quentinorh/biodata-pico/pics/001.jpg

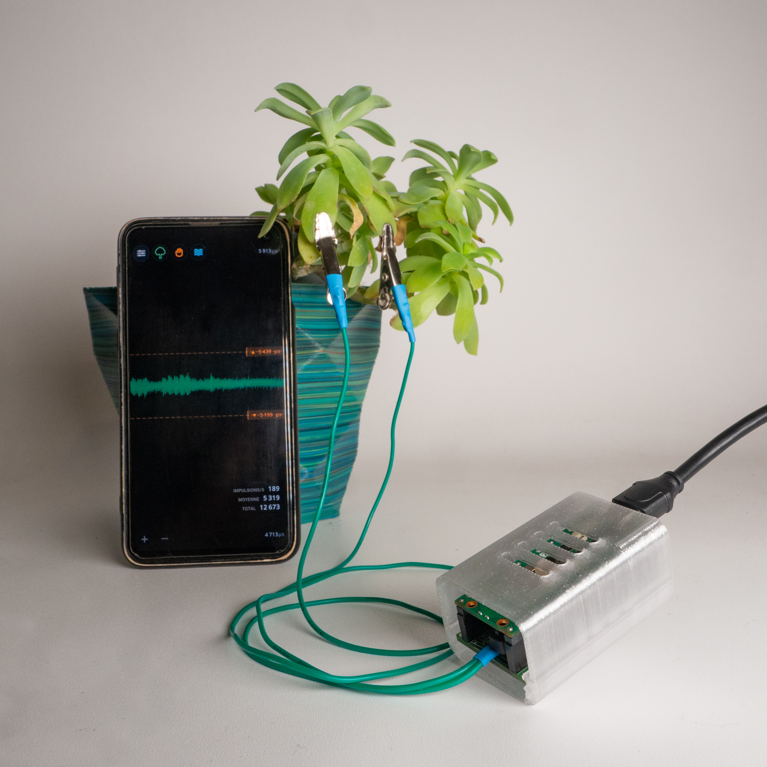
pics/001.jpg
