quentinorh/biodata-pico/pics/002.jpg

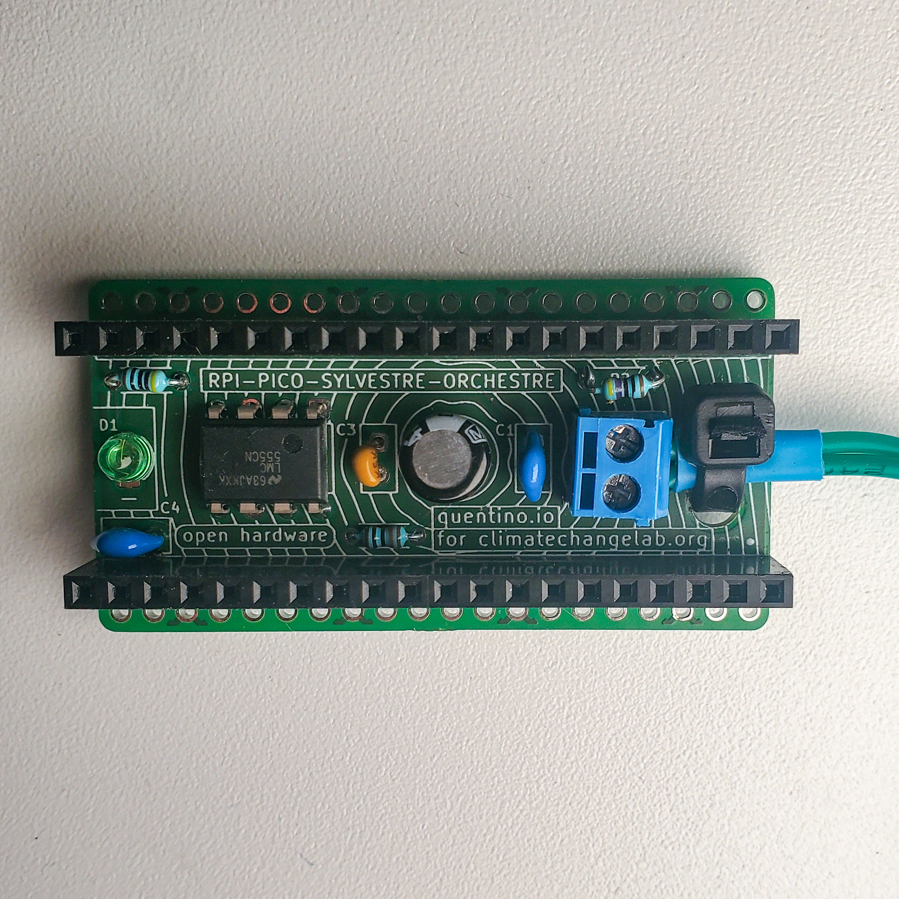
pics/002.jpg
