quentinorh/biodata-pico/pics/003.jpg

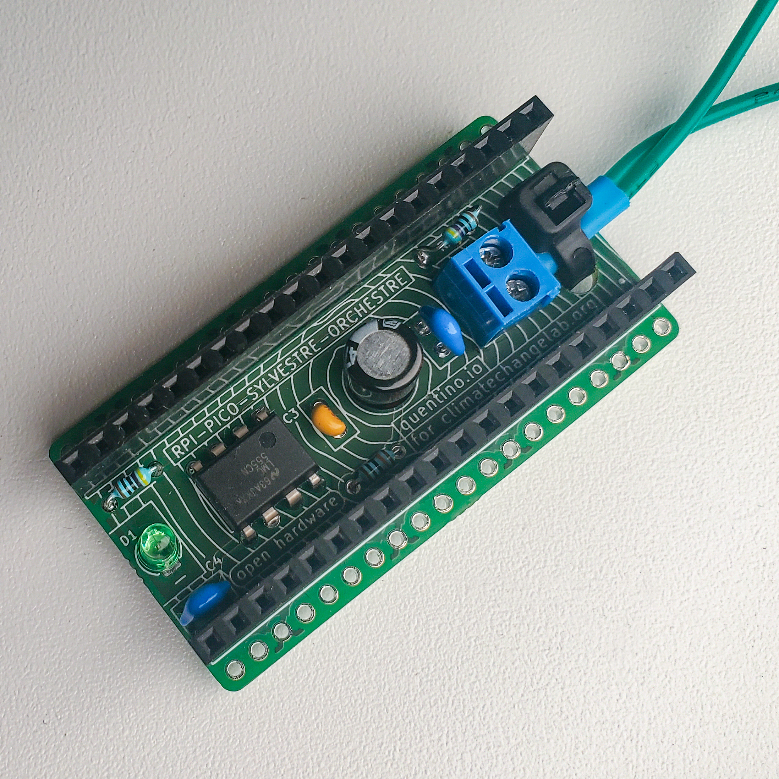
pics/003.jpg
