quentinorh/biodata-pico/pics/004.jpg

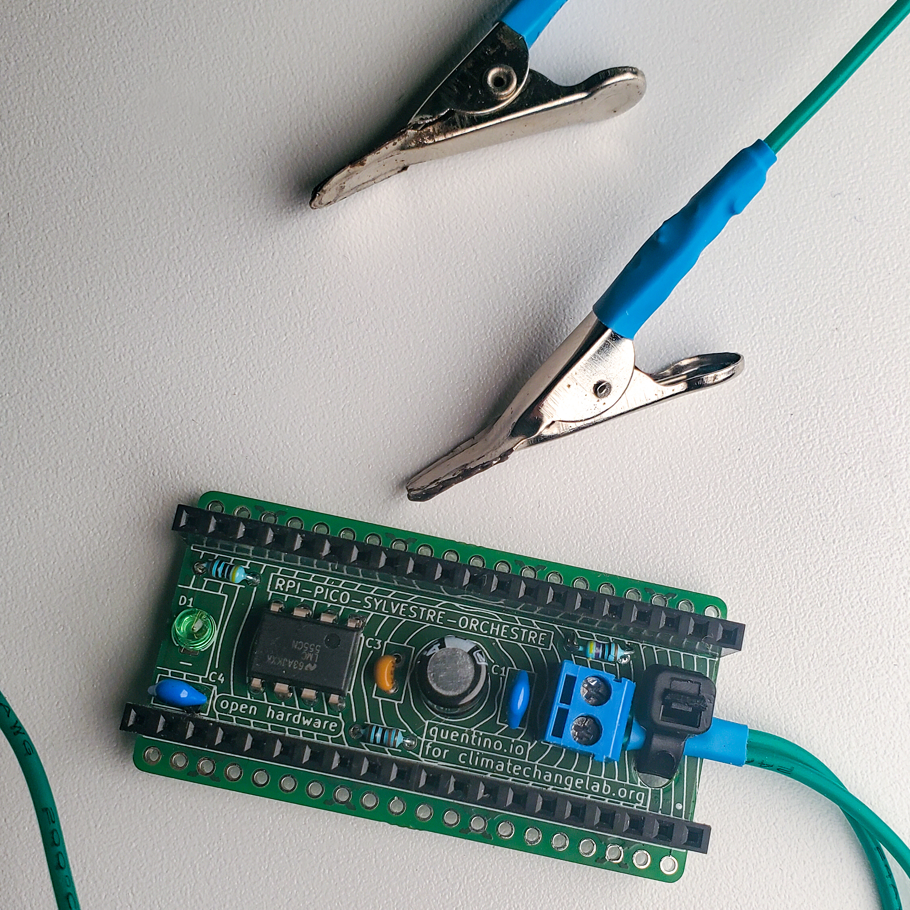
pics/004.jpg
