quentinorh/biodata-pico/pics/005.jpg

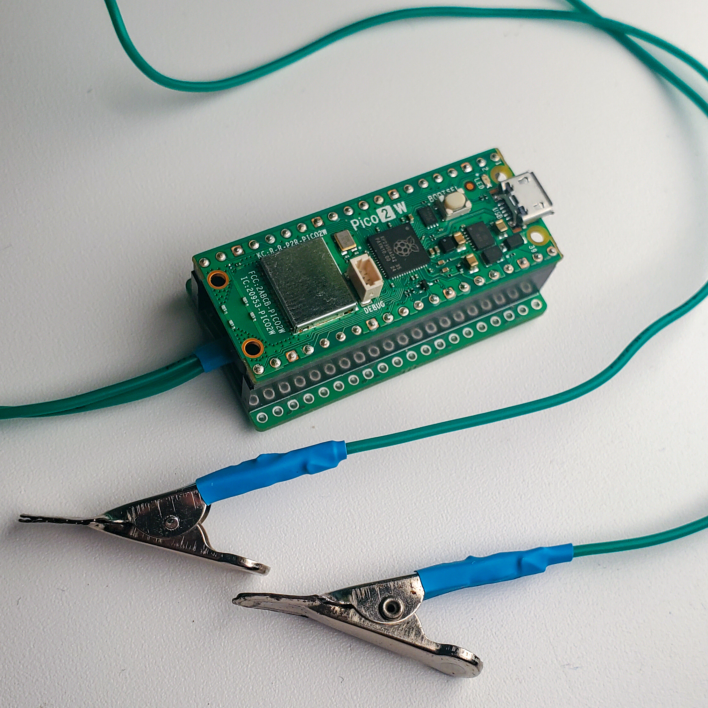
pics/005.jpg
