quentinorh/biodata-pico/pics/006.jpg

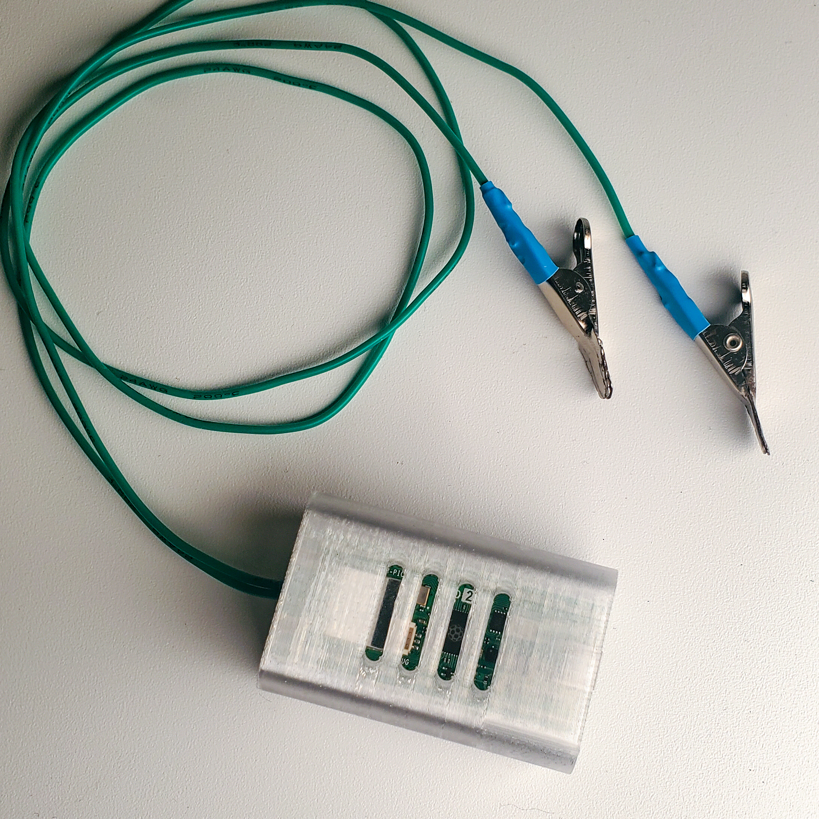
pics/006.jpg
