quentinorh/biodata-pico/pics/007.jpg

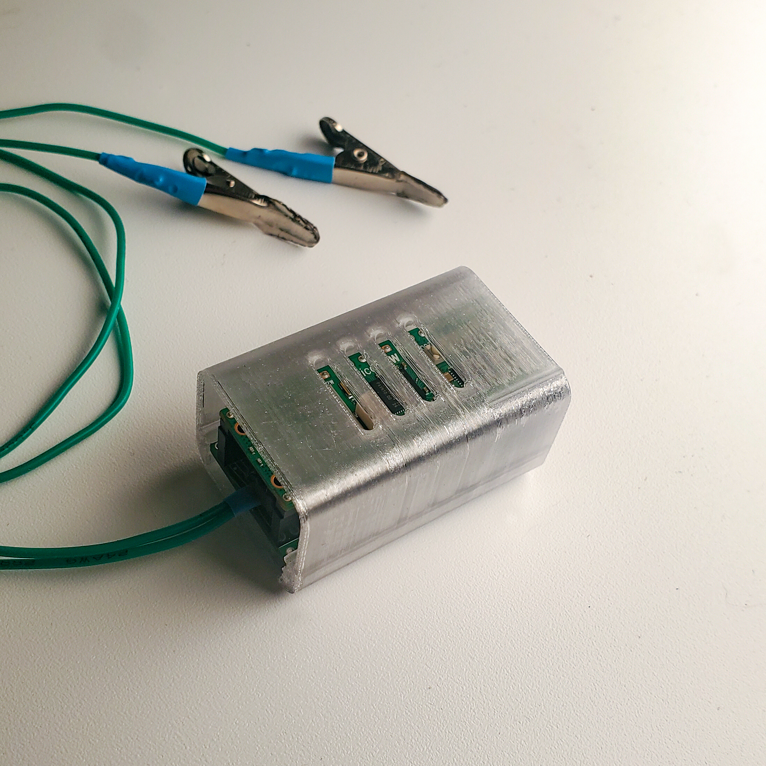
pics/007.jpg
