quentinorh/biodata-pico/touchdesigner/previews/04-fort.png

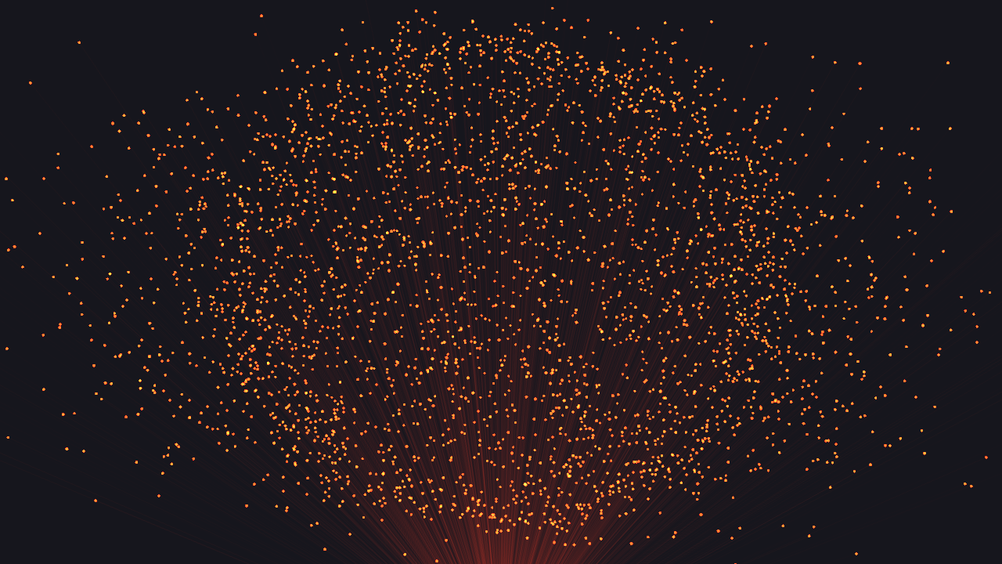
touchdesigner/previews/04-fort.png
