quentinorh/biodata-pico/touchdesigner/previews/05-tetraedre.png

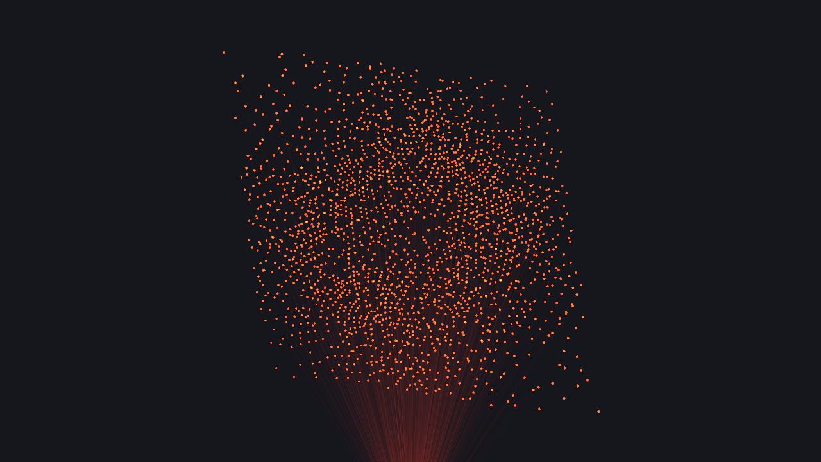
touchdesigner/previews/05-tetraedre.png
