quentinorh/biodata-pico/touchdesigner/previews/06-cube.png

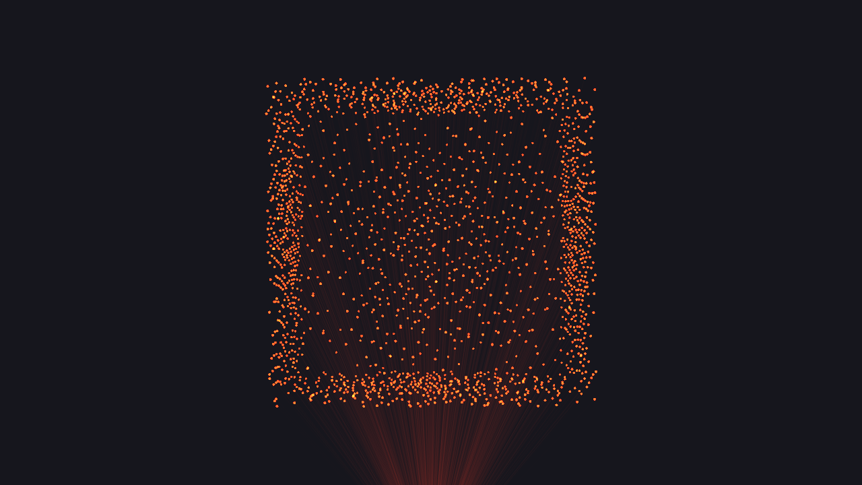
touchdesigner/previews/06-cube.png
