quentinorh/biodata-pico/touchdesigner/previews/07-octaedre.png

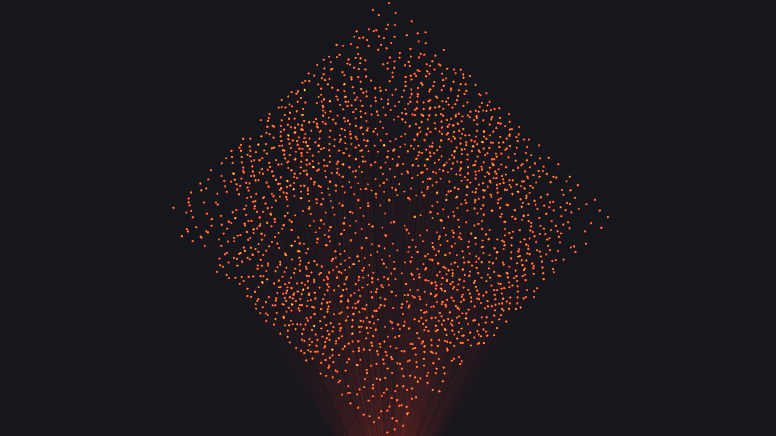
touchdesigner/previews/07-octaedre.png
