quentinorh/biodata-pico/touchdesigner/previews/08-dodecaedre.png

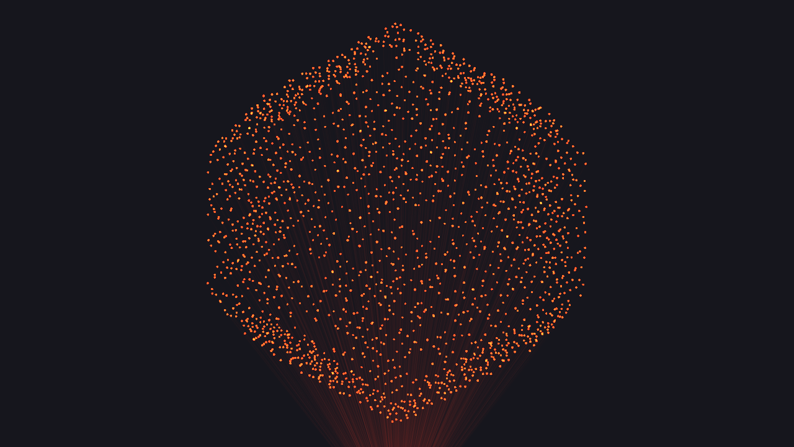
touchdesigner/previews/08-dodecaedre.png
