quentinorh/biodata-pico/touchdesigner/previews/v1-sans-laser/02-toucher.png

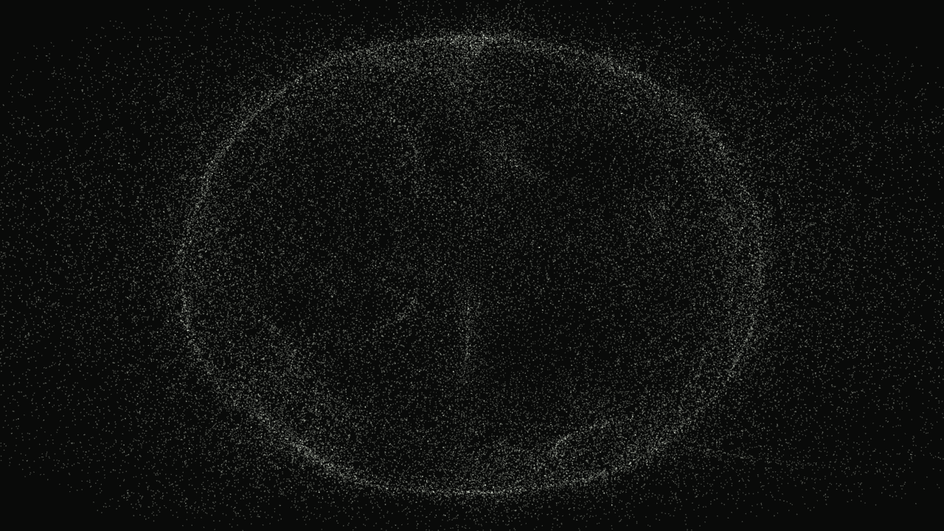
touchdesigner/previews/v1-sans-laser/02-toucher.png
