quentinorh/biodata-pico/touchdesigner/previews/v1-sans-laser/03-fort.png

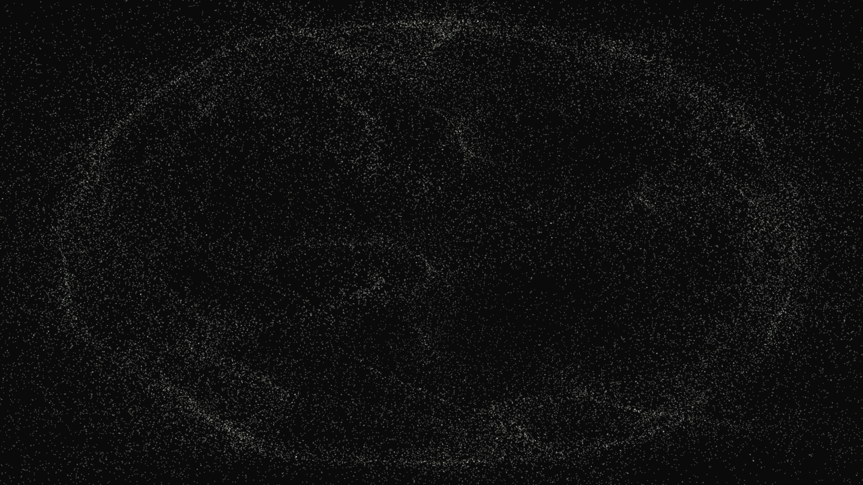
touchdesigner/previews/v1-sans-laser/03-fort.png
