quentinorh/biodata-pico/case/case_pico_sylvestre_orchestre.step

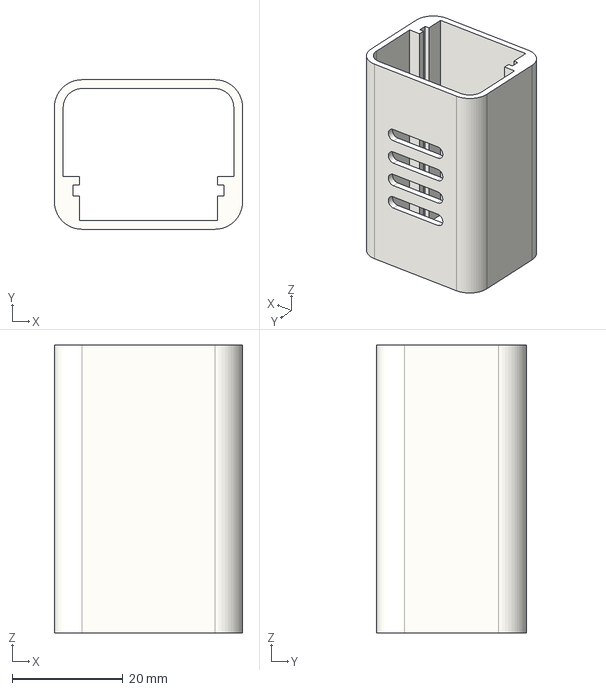
[picture p17: CAD file, 2026-10-29]
case/case_pico_sylvestre_orchestre.step
34.0 x 27.0 x 52.0 mm
