quentinorh/biodata-pico/(list of files, cad)

Other CAD files:
case/case_pico_sylvestre_orchestre.3mf
case/case_pico_sylvestre_orchestre.f3d
case/case_pico_sylvestre_orchestre.stl
