quentinorh/biodata-pico/pcb/Schematic.pdf

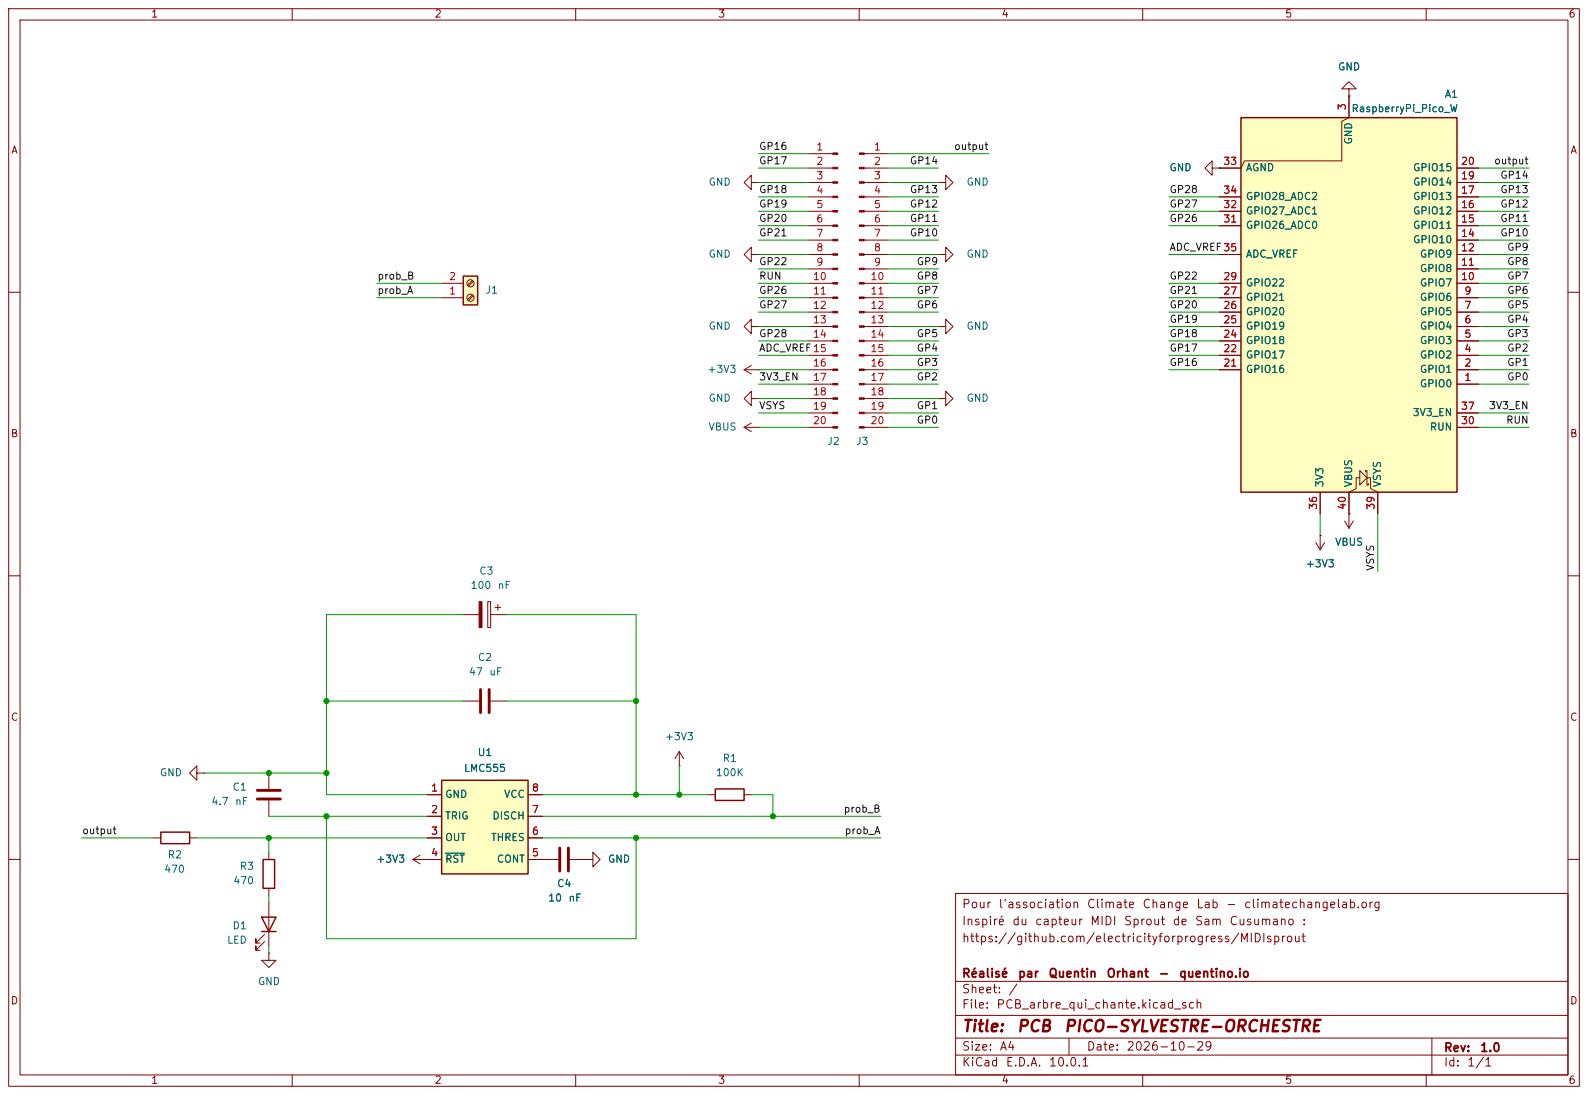
[picture p18: page 1]

Inspiré du capteur MIDI Sprout de Sam Cusumano : Pour l'association Climate Change Lab - climatechangelab.org

https://github.com/electricityforprogress/MIDIsprout

Réalisé par Quentin Orhant - quentino.io
Sheet: /
File: PCB_arbre_qui_chante.kicad_sch
Title: PCB PICO-SYLVESTRE-ORCHESTRE

Size: A4 | Rev: 1.0
KiCad E.D.A. 10.0.1 | Id: 1/1
