quentinorh/biodata-pico/pcb/PCB_arbre_qui_chante/PCB_arbre_qui_chante.kicad_pcb

## KiCad design pcb/PCB_arbre_qui_chante/PCB_arbre_qui_chante.kicad_pcb (2026-10-29)

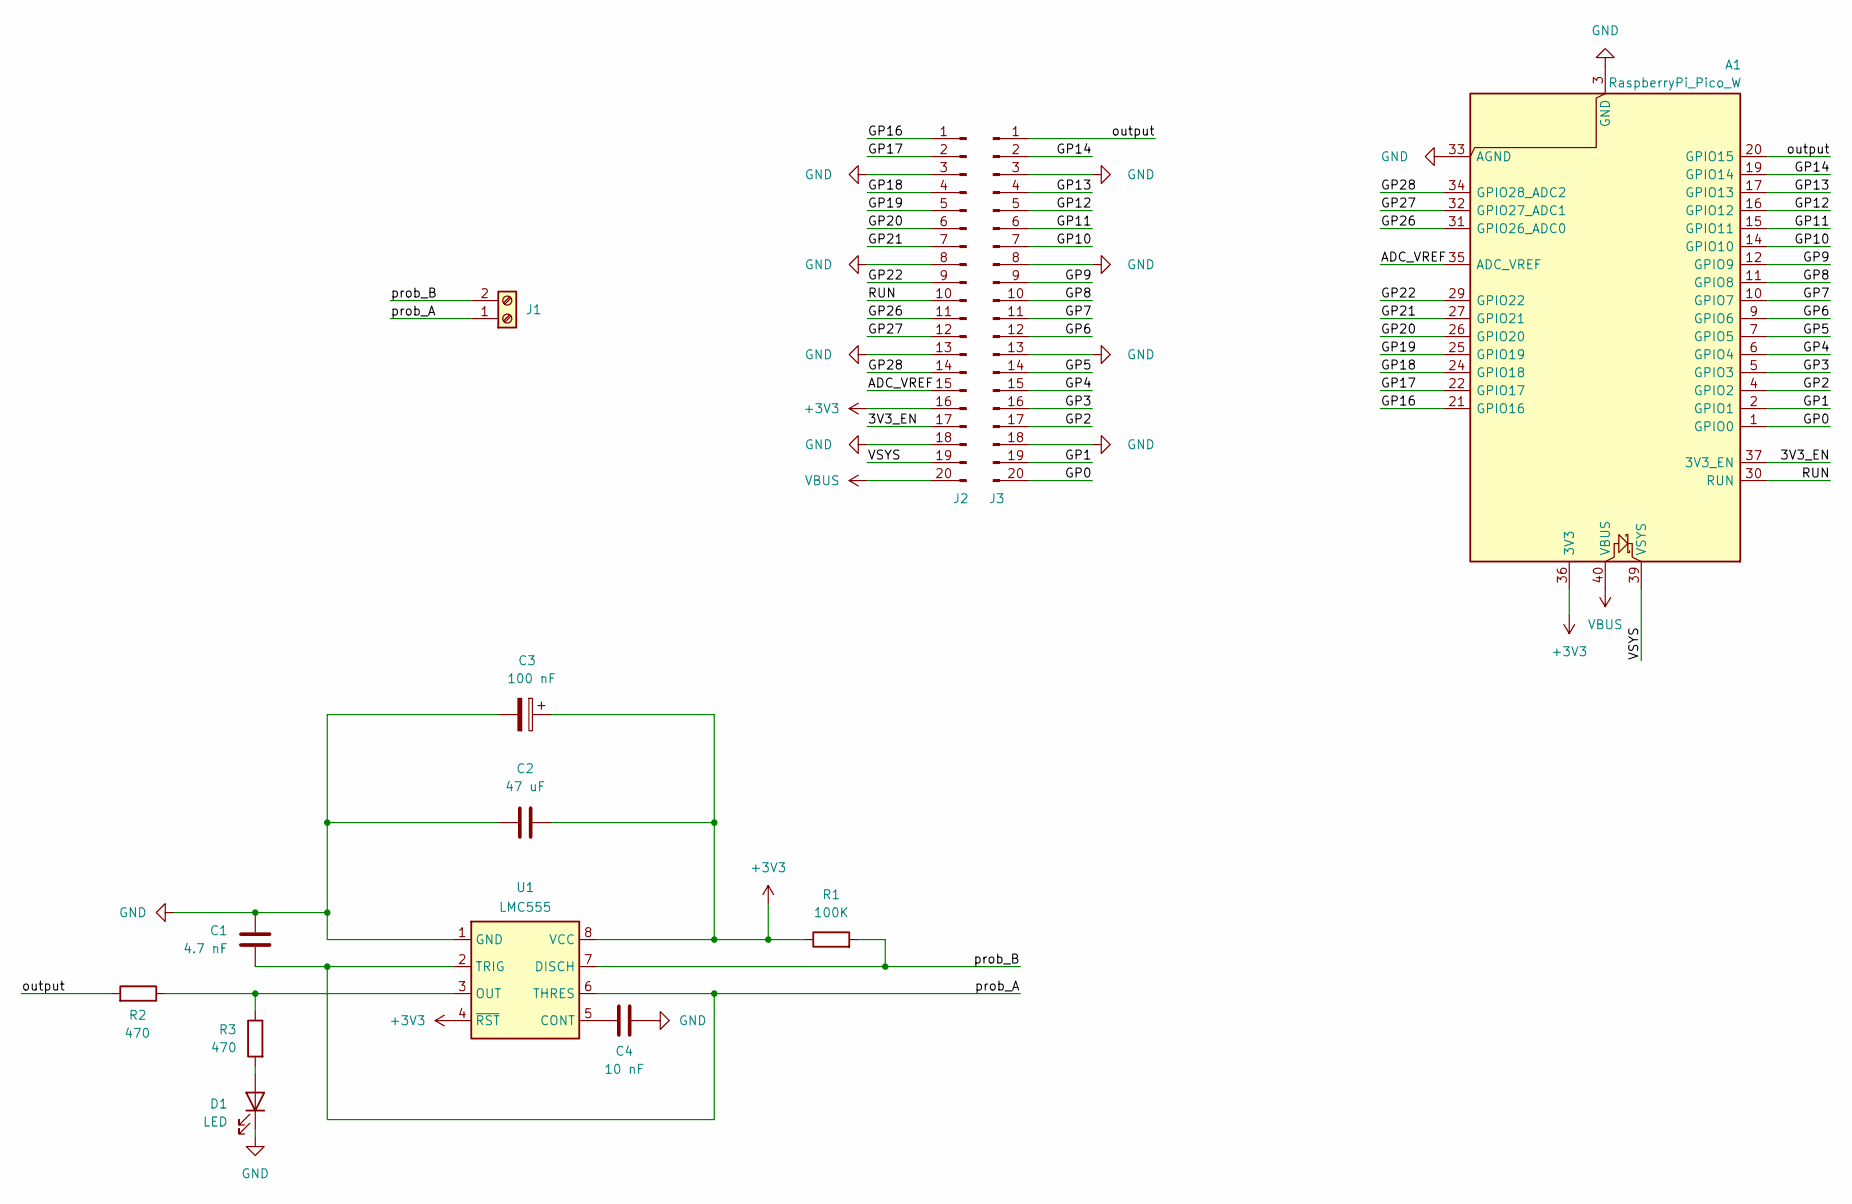
[picture p19: schematic PCB_arbre_qui_chante.kicad_sch, PCB PICO-SYLVESTRE-ORCHESTRE]

Parts:
A1: RaspberryPi_Pico_W; RaspberryPi_Pico_Common_THT-pinsocket
C1: 4.7 nF
C2: 47 uF
C3: 100 nF
C4: 10 nF
D1: LED
J1: Screw_Terminal_01x02
J2, J3: Conn_01x20_Pin
R1: 100K
R2, R3: 470
U1: LMC555; DIP-8_W7.62mm

Connections:
+3V3: A1.36 (3V3), C2.1, C3.1, J2.16, R1.1, U1.4 (~RST), U1.8 (VCC)
/3V3_EN: A1.37 (3V3_EN), J2.17
/ADC_VREF: A1.35 (ADC_VREF), J2.15
/GP0: A1.1 (GPIO0), J3.20
/GP1: A1.2 (GPIO1), J3.19
/GP2: A1.4 (GPIO2), J3.17
/GP3: A1.5 (GPIO3), J3.16
/GP4: A1.6 (GPIO4), J3.15
/GP5: A1.7 (GPIO5), J3.14
/GP6: A1.9 (GPIO6), J3.12
/GP7: A1.10 (GPIO7), J3.11
/GP8: A1.11 (GPIO8), J3.10
/GP9: A1.12 (GPIO9), J3.9
/GP10: A1.14 (GPIO10), J3.7
/GP11: A1.15 (GPIO11), J3.6
/GP12: A1.16 (GPIO12), J3.5
/GP13: A1.17 (GPIO13), J3.4
/GP14: A1.19 (GPIO14), J3.2
/GP16: A1.21 (GPIO16), J2.1
/GP17: A1.22 (GPIO17), J2.2
/GP18: A1.24 (GPIO18), J2.4
/GP19: A1.25 (GPIO19), J2.5
/GP20: A1.26 (GPIO20), J2.6
/GP21: A1.27 (GPIO21), J2.7
/GP22: A1.29 (GPIO22), J2.9
/GP26: A1.31 (GPIO26_ADC0), J2.11
/GP27: A1.32 (GPIO27_ADC1), J2.12
/GP28: A1.34 (GPIO28_ADC2), J2.14
/RUN: A1.30 (RUN), J2.10
/VSYS: A1.39 (VSYS), J2.19
/output: A1.20 (GPIO15), J3.1, R2.2
/prob_A: C1.2, J1.1, U1.2 (TRIG), U1.6 (THRES)
/prob_B: J1.2, R1.2, U1.7 (DISCH)
GND: A1.3 (GND), A1.8 (GND), A1.13 (GND), A1.18 (GND), A1.23 (GND), A1.28 (GND), A1.33 (AGND), A1.38 (GND), C1.1, C2.2, C3.2, C4.1, D1.1 (K), J2.3, J2.8, J2.13, J2.18, J3.3, J3.8, J3.13, J3.18, U1.1 (GND)
unnamed: D1.2 (A), R3.2
unnamed: C4.2, U1.5 (CONT)
unnamed: R2.1, R3.1, U1.3 (OUT)
VBUS: A1.40 (VBUS), J2.20

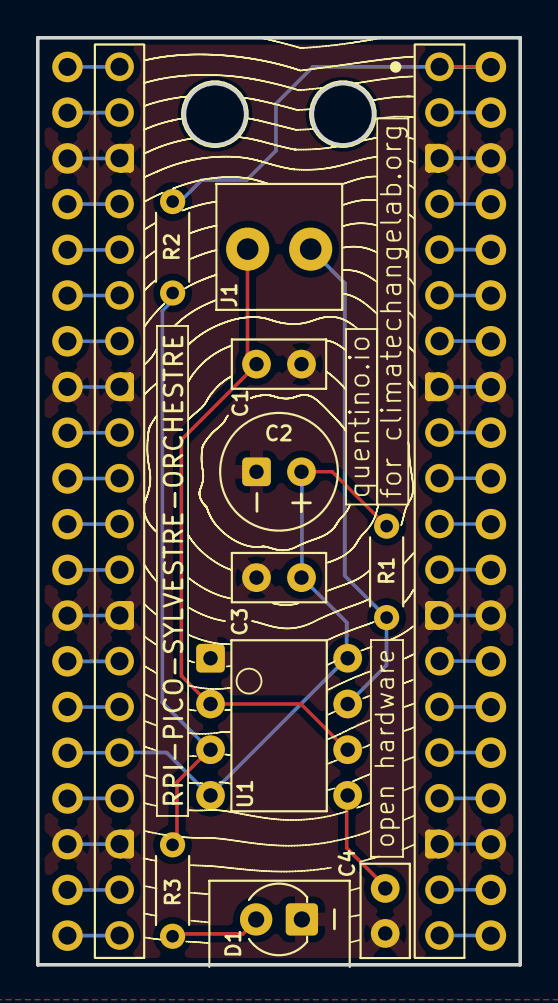
[picture p20: board PCB_arbre_qui_chante.kicad_pcb from above]

Board: 2 copper layers, 26.8 x 51.5 mm, 13 parts (0 on the bottom side), 38 nets.
