quentinorh/biodata-pico/(commit log)

2026-10-14 Conserve l''état actuel de la plante musicale avant l''essai Tone.js.
2026-10-29 Documente le projet et enregistre l'état actuel du firmware, de l'interface et des patches.
2026-10-29 cleaning BOM and readme
    [BOM-v1-mouser.csv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]
2026-10-29 change readme.md
    [BOM-v1-mouser.csv, PCB_arbre_qui_chante.kicad_pcb]
2026-10-31 Plante musicale : quantizer, courbe d'agitation, interface mobile
    - Quantizer : une voix Ambient Garden (Carillon, Cloches, Vibraphone, Cordes,
    Cloche d'eau) avec la chaîne d'effets de chaque patch, calée sur le BPM.
    L'agitation de la plante choisit la subdivision (1/4 à 1/32, ternaire),
    delay synchronisé, octave, gamme et tonique.
    - Pistes Végétal et Toucher : le paramètre lié suit une courbe d'agitation
    (quatre points, traits déplaçables, dessin au doigt), mesurée par rapport
    au calme habituel de la plante. Piste Ambiance retirée.
    - Seuils dynamiques calés sur l'amplitude de la plante, et non plus sur le
    zoom : la contrebasse se déclenche au toucher. Marge réglab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
2026-10-31 Panneaux séparés, volume par instrument, sliders et tuiles d'instrument
    - Le bouton Réglages ouvre VOL et BPM seuls ; les pastilles ouvrent leur
    instrument, avec son volume en tête du panneau. « Volume » du patch
    renommé Préampli.
    - Quantizer : onglet comme les pistes, avec son interrupteur et son volume.
    - Sliders : nom et valeur au-dessus, piste fine, bouton rond ; réglages
    groupés en carte, instrument choisi en tuiles (benchmark Mobbin :
    Sonos, Ladder, Breathwrk).
    - Mobile : dock des pastilles en bas, courbe visible au-dessus du panneau,
    glissé des sliders au doigt, lignes de seuil attrapables.
    - Desktop : réglages de l'instrument dépliés dans le panneau.
    - Base :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
2026-10-31 Interface dry : Inter embarquée, typo resserrée, choix d'instrument en sheet
    - Inter (variable, latin, 48 Ko) servie par la carte ; échelle 11/12/13 px
    et gris inspirés de Linear. Le firmware sert les .woff2.
    - Instrument choisi dans son propre bottom sheet (liste compacte), déplié
    sur place sur desktop. Les sheets passent au-dessus du dock.
    - Réglages : VOL et BPM côte à côte, sans titre ni carte. Icônes rouage,
    fichier, info seulement avec les Réglages.
    - Mobile : max, min, impulsions/s, moyenne et total sur une ligne en haut.
    - Sliders resserrés, remplissage plus visible ; options du quantizer en
    pilules animées ; courbe d'agitation pleine largeur.
    - Descriptions sup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
2026-10-31 Graphe et typo affinés : traits fins, seuils nets, mesures en Inter
    - Signal en 1,5 px arrondi, aux couleurs des pistes ; seuils en filet
    d'un pixel calé sur le demi-pixel, pointillé court.
    - Étiquettes de seuils, extrêmes et statistiques en Inter tabulaire,
    sans cadres colorés.
    - Courbe d'agitation et jauge du quantizer : mêmes traits fins.
2026-10-31 Mobile : le dock passe sous les bottom sheets
2026-10-31 En-tête d'instrument en une surface ; dock sous les sheets sur mobile
    - Vignette au picto de la piste, nom, paramètre piloté, interrupteur à
    droite (benchmark Mobbin : Spotify, Garmin, Suno).
    - Sur mobile, le dock sort de la barre du haut, dont la couche (z-index 40)
    le gardait au-dessus des bottom sheets.
2026-10-31 Mesures mobiles en grille à colonnes fixes et chiffres tabulaires
    La propriété font raccourcie remettait les chiffres en largeur variable ;
    chaque valeur a maintenant sa colonne et sa largeur, rien ne bouge.
2026-10-31 Mobile : le panneau prend la hauteur de son contenu, sans défilement
    Panneau jusqu'à 76 % de l'écran, courbe calée au-dessus via sa hauteur
    mesurée ; scène de la courbe et espacements du quantizer resserrés.
2026-11-02 ajout d'une courbe de sensibilité aux pistes
